Ting711/I-Robonator/v-photos/top view.jpg

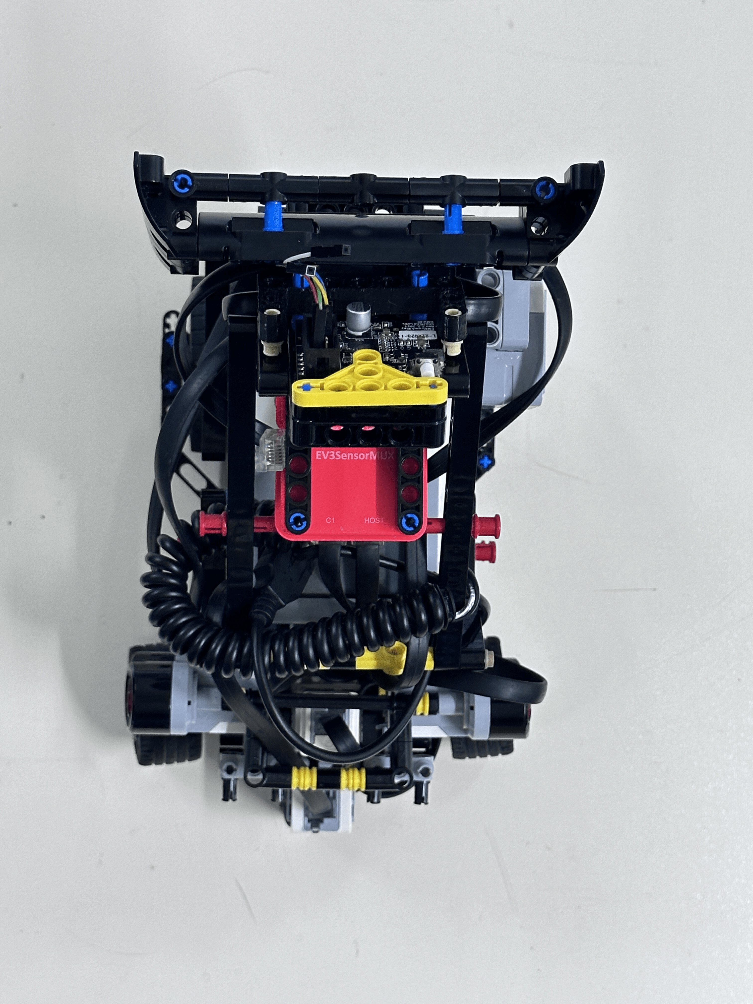
v-photos/top view.jpg
