Ting711/I-Robonator/t-photos/I-Robonator Team Picture 1.jpg

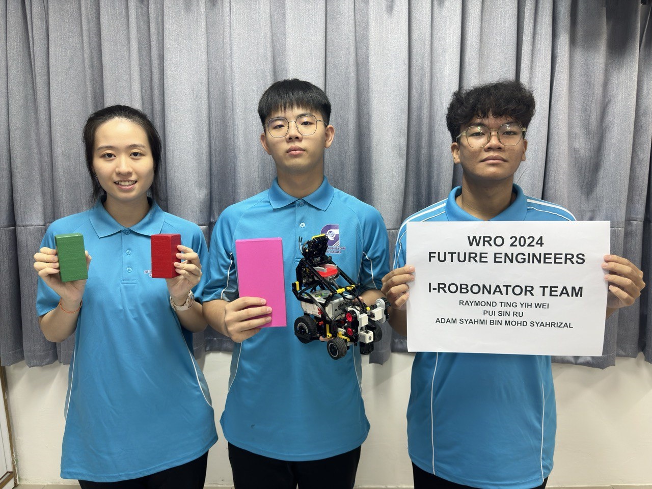
t-photos/I-Robonator Team Picture 1.jpg
