Ting711/I-Robonator/models/README.md

This folder contains the building instructions for the self-driving car, along with the assembly guidelines for the 3D-printed parts.
