Ting711/I-Robonator/src/README.md

This folder includes the detailed programs for the Open Challenge and Obstacle Challenge, along with the flowcharts for both challenges.
