Ting711/I-Robonator/schemes/README.md

This folder contains the schematic diagram of the electronic components used in the self-driving car, as well as the diagrams for the Open Challenge and Obstacle Challenge.
