Ting711/I-Robonator/t-photos/I-Robonator Team Picture 2.jpg

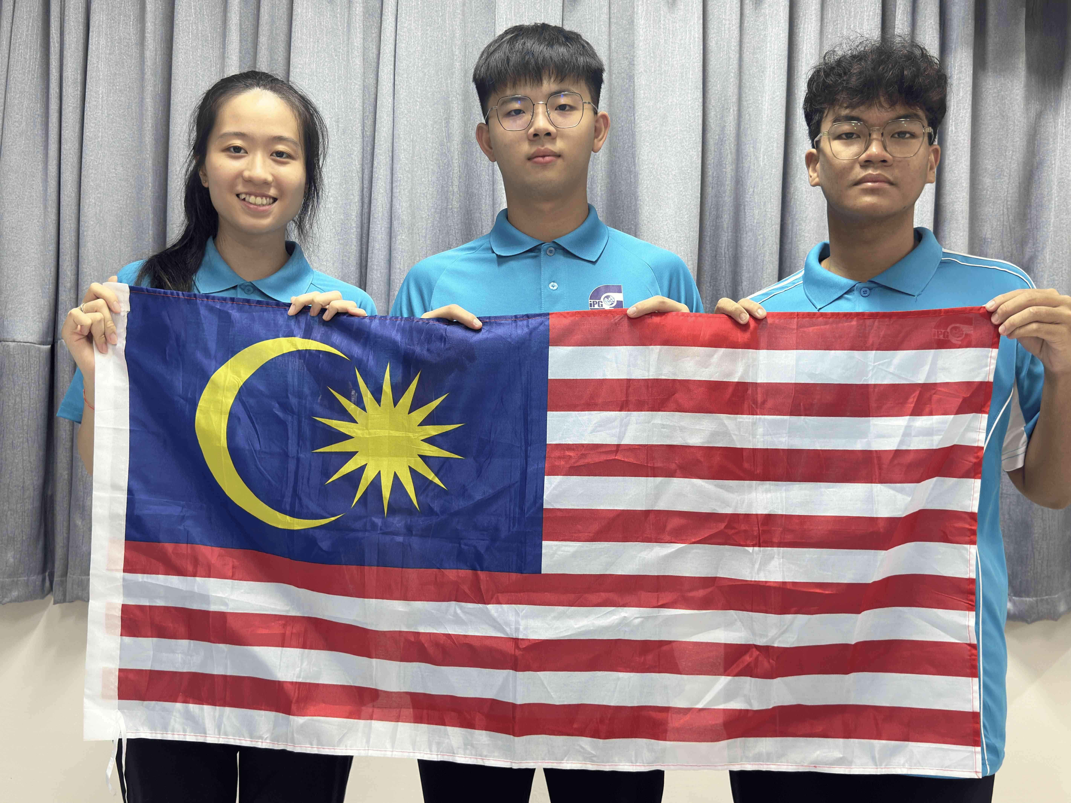
t-photos/I-Robonator Team Picture 2.jpg
