Ting711/I-Robonator/models/I-Robonator Pixy Holder 2.stl

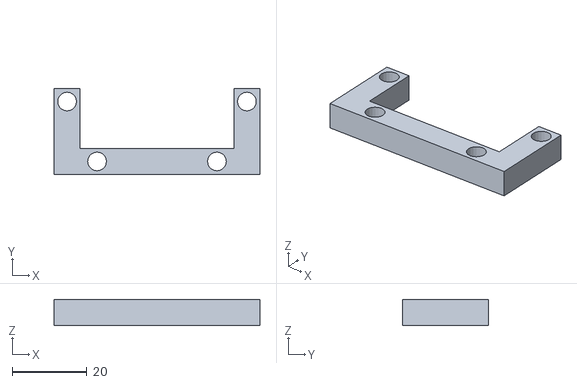
[picture p4: CAD file, 2024-11-15]
models/I-Robonator Pixy Holder 2.stl
55.0 x 23.0 x 7.00
