Ting711/I-Robonator/schemes/I-Robonator EV3 Brick Schematic Diagram.pdf

# Ram Flash

MCU; uSD; Display Button GUI; Output; Power; USB Host Client; Pin 5: I/O (OC), Tacho, PD,PU,; ADC; TIAM1808; See page 6; See page 4; See page 5; Title; Project Number; Engineer/constructer; Schematic Name; Drafter; Date (YYYY/MM/DD); Version; Sheet; Page Size; BHP; BHP/JU

9V battery
5 V buck boost 2 A>
Power up sequence
5 V Current limiter
5V on/off
Current measurement on overall current
Voltage check on Batteries
5V BURN OUT

mDDR 1,8V 64 Mbyte 16 bit Wide
uSD CARD HC version up to 32 Gbyte
I2C boot ROM for secure boot
SPI flash 3V3 16Mbyte

See page 2 and 3

USB Client 1,5 , 12 and 480 MBit
USB Host 1,5, 12 Mbit
5 Volt +500 mA (1,2A MAX)
Current limiter
Apple Autentic IC + Decoding MCU

Display, B&W, 178X128 Reflective
6 Buttons UP, DOWN, L, R, ACK/ON, BACK
R and G Diodes
Sound out

Input

4 Output
Pin 1: Motor Out PWM
Pin 2: Motor Out PWM PU to pin 6
Pin 3: Ground
Pin 4: 5 Volt +20 mA
Pin 6: I Tacho, PU from Mx1
Auto Detect Motor and Sensor

4 Input
Pin 1: ADC 5 V PU
Pin 2: I/O, PU,PD
Pin 5: I/O, PU,
SCK(I2C), UART(TX)
Pin 6: I/O, ADC 5 V, PD,
SDA(I2C), UART(RX)
Auto detect Sensor and Motor

Buttons
Diodes
are on the KEYPAD PCB

Note:
PU = Pull Up
PD = Pull Down
SDA = Seriel DATA
SCK = Seriel Clock
ADC = Analog Digital Converter
USB = Universial Serial Bus
UART = Universal Asynchronous Receiver/Transmitter
PWM = Pulse Wide Modulation
GUI = Graphical User Interface
B&W = Black and White
mDDR = Mobile Double Data Rate synchronous DRAM
R = Red
G = Green
uSD = micro Secure Digital
I2C = Inter-Integrated Circuit
SPI = Serial Peripheral Interface Bus
PCB = Printed Circuit Board

Date (YYYY/MM/DD)

D

D


GP6_11, 6_12 and 6_13 not be moved
2 green diodes, internal PU

Possible alternative boot Flash SPI

When Write Control (WC) is driven High.
When unconnected, the signal is internally read as VIL,
and Write operations are allowed.

CMD | 3

- Part of Mech. BOM

SW UART input PRU

Connector to KEYPAD PCB

Short wire twisted to speaker

D

D


Protection for
Vbat below 2,7 V
And no 9 Volt on
the 3V3 rail during
Power up

DQS1/DQS0 , DQM1/DQM0 : Target 50 ohms to GND for
each signal Keep away from other signals.
CLKP/CLKN : Route Clock Signal as 100ohm.Differential
Pair,match Trace length

ROUTE THIS PAIR OF SIGNALS PHYSICALLY CLOSE
TO THE DATA BUS. TOTAL TRACE LENGTH OF
STRBEN + STRBEN_DEL SHOULD BE SUM OF DDR
CLOCK LENGTH +AVG(DQS0 + DQS1) LENGTH. KEEP
BOTH SIGNALS CLOSE TO EACH OTHER. THERE IS
NO IMPEDANCE REQUIREMENT FOR THESE SIGNALS

240 mS delay open drain SC70

ON and BACK HOLD BUTTON RESET DELAY

D | D

# INPUT A


TX Enable on Port A

## MotorA

## MotorB



Mixed PWM/PFM MODE

Close to mosfet both snubber branches
Mounted on each side on the FET

Total Cap. 35 uF
Bulk and decoupling for every 2 supply pins

For testing of ground directly
