Ting711/I-Robonator/src/I-Robonator Open Challenge Flow Chart.pdf

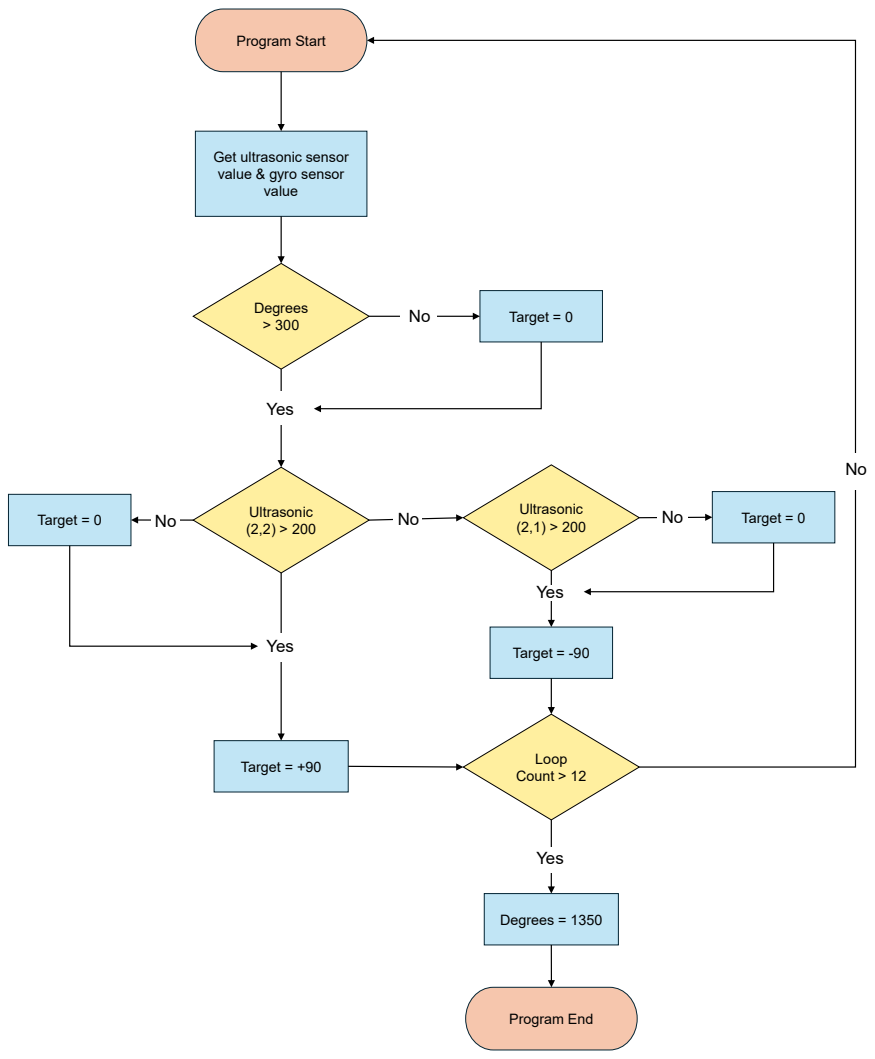
[picture p11: page 1]
Program Start; Degrees; Target = 0; Ultrasonic (2,2) > 200; Yes; Ultrasonic (2,1) > 200; Target = -90; Target = +90; Loop Count > 12; Program End; Degrees = 1350

Get ultrasonic sensor
value & gyro sensor
value
