Ting711/I-Robonator/(commit log)

2024-11-09 Create schematic diagram
2024-11-15 Rename BOM_I-ROBONATOR.pdf to I-Robonator Build Of Material.pdf
2024-11-15 Rename I-Robocom Color Sensor Schematic Diagram.pdf to I-Robonator Color Sensor Schematic Diagram.pdf
2024-11-15 Rename 4. Final (Pixy2_schematic).pdf to I-Robonator Pixy2 Camera Schematic Diagram.pdf
2024-11-15 Rename 3. Final (Ultrasonic sensor schematic).pdf to I-Robonator Ultrasonic Sensor Schematic Diagram.pdf
2024-11-15 Rename 2. Final (Gyro sensor schematic).pdf to I-Robonator Gyro Sensor Schematic Diagram.pdf
2024-11-15 Rename 1. Final (EV3 Brick schematic).pdf to I-Robonator EV3 Brick Schematic Diagram.pdf
